kraakenstuff/PSU/PSU - Transformer.kicad_pcb

## KiCad design PSU - Transformer.kicad_pcb (2022-03-05)

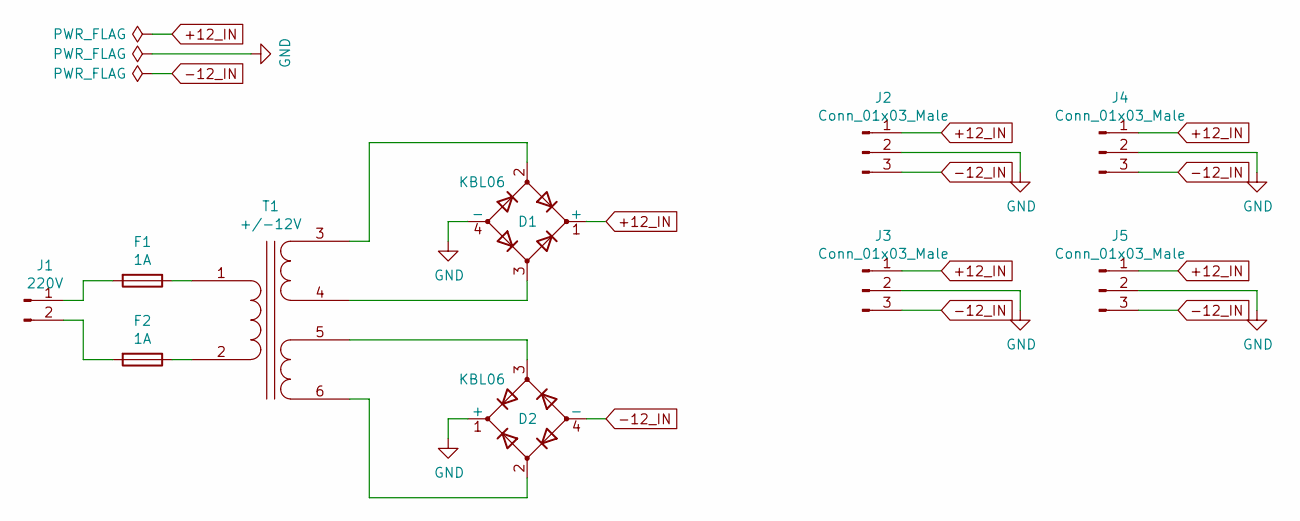
[picture p1: schematic PSU - Transformer.kicad_sch]

Parts:
D1, D2: KBL06; Diode_Bridge_18.5x5.5
F1, F2: 1A; Fuseholder5x20_horiz_SemiClosed_Casing10x25mm
J1: 220V; Terminal 2 contacts
J2, J3, J4, J5: Conn_01x03_Male; Klema x3
T1: +/-12V; Toroidal transformer 220V 150VA 2x12V

Connections:
+12_IN: D1.1 (+), J2.1, J3.1, J4.1, J5.1
-12_IN: D2.4 (-), J2.3, J3.3, J4.3, J5.3
GND: D1.4 (-), D2.1 (+), J2.2, J3.2, J4.2, J5.2
unnamed: D1.2, T1.3 (SA)
unnamed: D1.3, T1.4 (SB)
unnamed: D2.2, T1.6 (SD)
unnamed: D2.3, T1.5 (SC)
unnamed: F1.1, T1.1 (AA)
unnamed: F1.2, J1.1
unnamed: F2.1, T1.2 (AB)
unnamed: F2.2, J1.2

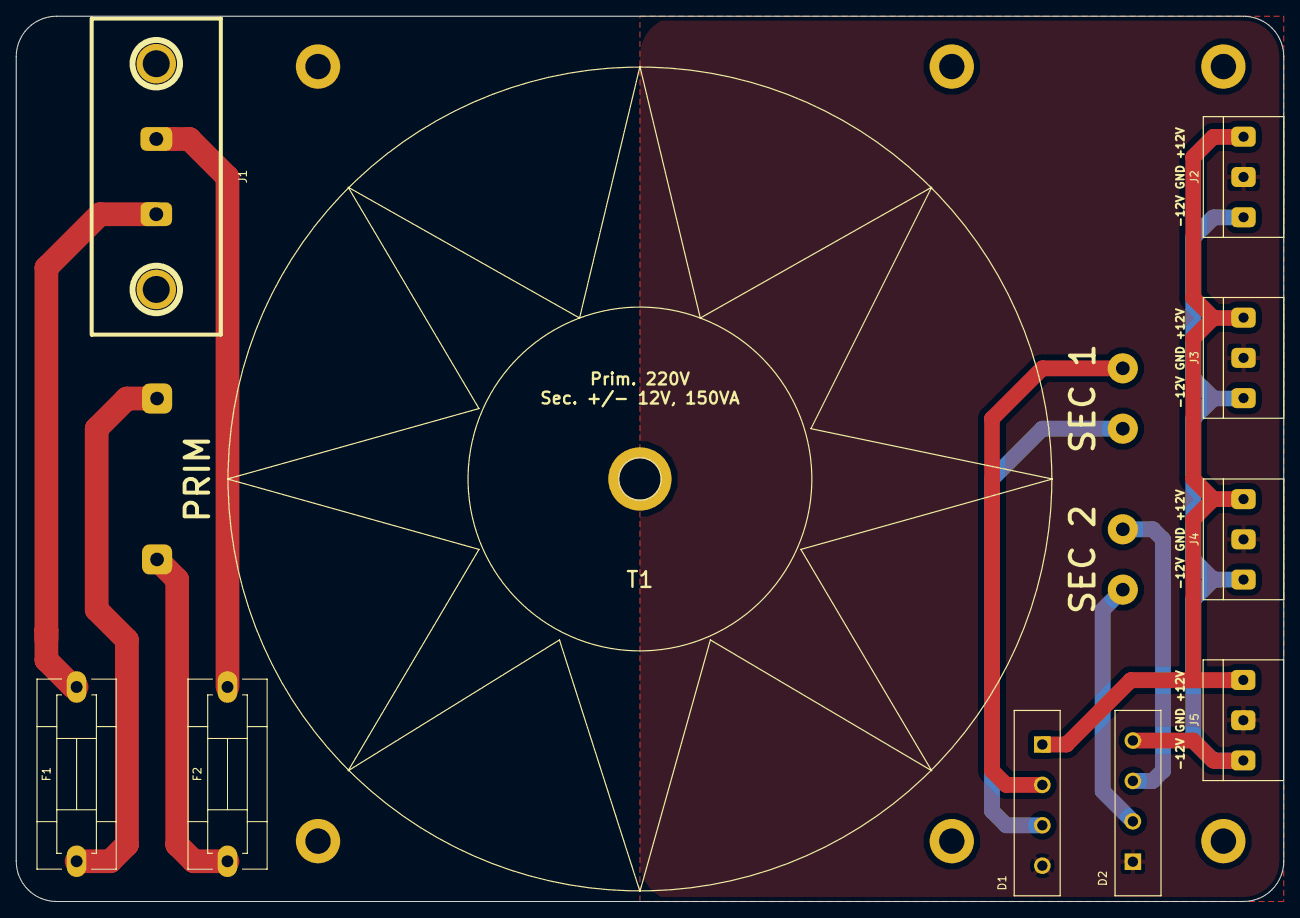
[picture p2: board PSU - Transformer.kicad_pcb from above]

Board: 2 copper layers, 160.0 x 111.8 mm, 10 parts (0 on the bottom side), 11 nets.
