kraakenstuff/PSU/PSU - Filter.kicad_pcb

## KiCad design PSU - Filter.kicad_pcb (2022-03-05)

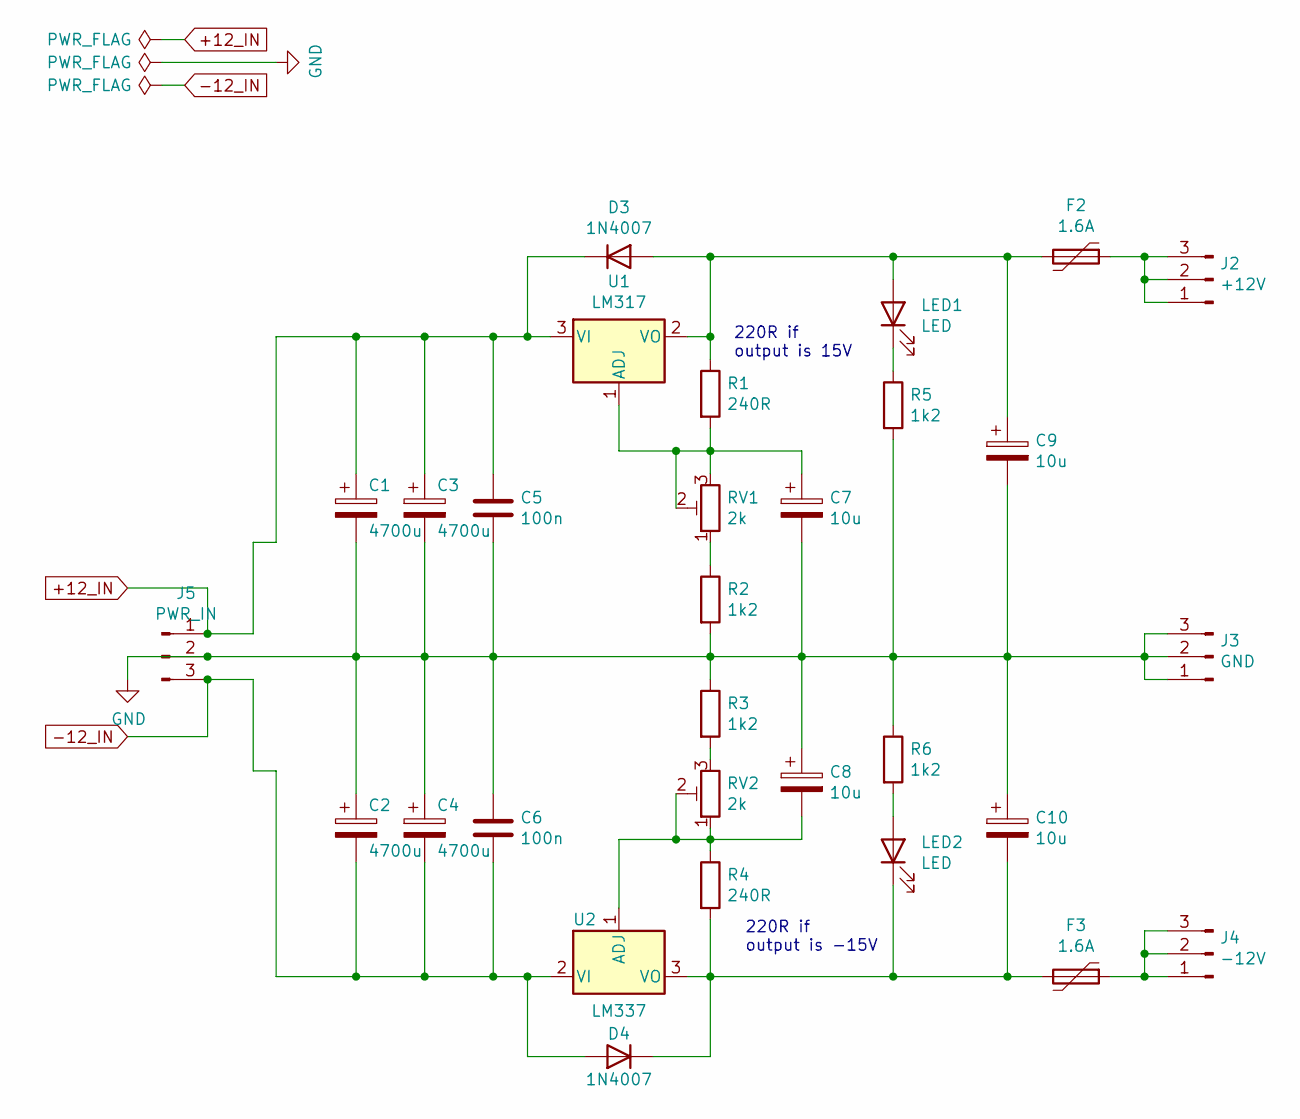
[picture p3: schematic PSU - Filter.kicad_sch]

Parts:
C1, C2, C3, C4: 4700u; CP_Radial_D17.0mm_P7.50mm
C5, C6: 100n; C_Rect_L10.0mm_W2.5mm_P7.50mm_MKS4
C7, C8, C9, C10: 10u; CP_Radial_D6.3mm_P2.50mm
D3, D4: 1N4007; D_DO-15_P12.70mm_Horizontal
F2, F3: 1.6A; C_Disc_D6.0mm_W2.5mm_P5.00mm
J2: +12V; Klema x3
J3: GND; Klema x3
J4: -12V; Klema x3
J5: PWR_IN; Klema x3
LED1, LED2: LED; LED_D5.0mm
R1, R4: 240R; R_Axial_DIN0414_L11.9mm_D4.5mm_P15.24mm_Horizontal
R2, R3: 1k2; R_Axial_DIN0414_L11.9mm_D4.5mm_P15.24mm_Horizontal
R5, R6: 1k2; R_Axial_DIN0207_L6.3mm_D2.5mm_P7.62mm_Horizontal
RV1, RV2: 2k; Potentiometer_Bourns_3296W_Vertical
U1: LM317; TO-220-3_Vertical
U2: LM337; TO-220-3

Connections:
+12_IN: C1.1, C3.1, C5.1, D3.1 (K), J5.1, U1.3 (VI); also elsewhere on the board
-12_IN: C2.2, C4.2, C6.2, D4.2 (A), J5.3, U2.2 (VI); also elsewhere on the board
GND: C1.2, C2.1, C3.2, C4.1, C5.2, C6.1, C7.2, C8.1, C9.2, C10.1, J3.1, J3.2, J3.3, J5.2, R2.2, R3.1, R5.2, R6.1; also elsewhere on the board
unnamed: C7.1, R1.2, RV1.2, RV1.3, U1.1 (ADJ)
unnamed: C8.2, R4.1, RV2.1, RV2.2, U2.1 (ADJ)
unnamed: C9.1, D3.2 (A), F2.2, LED1.2 (A), R1.1, U1.2 (VO)
unnamed: C10.2, D4.1 (K), F3.2, LED2.1 (K), R4.2, U2.3 (VO)
unnamed: F2.1, J2.1, J2.2, J2.3
unnamed: F3.1, J4.1, J4.2, J4.3
unnamed: LED1.1 (K), R5.1
unnamed: LED2.2 (A), R6.2
unnamed: R2.1, RV1.1
unnamed: R3.2, RV2.3

Notes on the sheet:
220R if output is -15V
220R if output is 15V

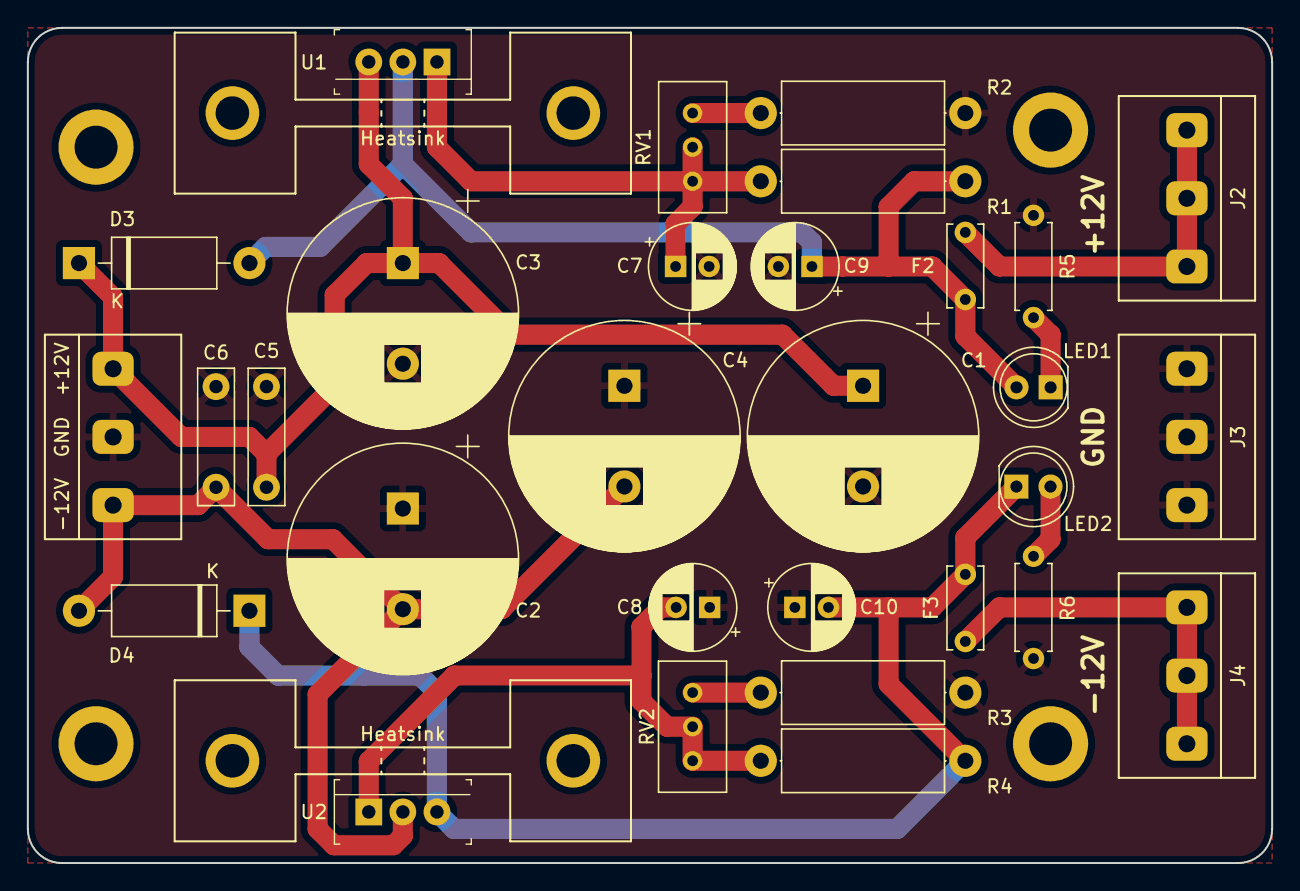
[picture p4: board PSU - Filter.kicad_pcb from above]

Board: 2 copper layers, 92.7 x 62.2 mm, 32 parts (0 on the bottom side), 13 nets.

Other parts of the board:
-12V  GND  +12V: PWR_IN; Klema x3
Heatsink: ALUMINIJUMSKI HLADNJAK TO-220/25; ALUMINIJUMSKI HLADNJAK TO-220_25
Heatsink#2: ALUMINIJUMSKI HLADNJAK TO-220/25; ALUMINIJUMSKI HLADNJAK TO-220_25

Their connections:
+12_IN: -12V GND +12V.1; also elsewhere on the board
-12_IN: -12V GND +12V.3; also elsewhere on the board
GND: -12V GND +12V.2; also elsewhere on the board
