kraakenstuff/PSU/(threads)

Thread 1 (2023-05-21):

BOM

Yulquen, 2023-05-21:
Hi. Thanks for sharing your design. Do you have a BOM for the boards? I could find most of the stuff, but can't recognize some components, like J1 on the transformer.
Thanks

Yulquen, 2023-05-21:
maybe something like that for J1
https://www.lcsc.com/product-detail/Barrier-Terminal-Blocks_Ningbo-Kangnex-Elec-WJ45C-A-2P_C8398.html
