kraakenstuff/PSU/(commit log)

2018-12-02 Release client. Fixed a short in +12 branch Changed 10uF footprint to 6.3/2.5mm New KiCad standard library Pointers to the KraakenStuffLib library
    [PSU - Filter [alternate].kicad_pcb, PSU - Filter.kicad_pcb, PSU - Filter.sch, PSU - Transformer.sch]
2018-12-02 Fixed library dependencies
    [PSU - Transformer.kicad_pcb, PSU - Transformer.sch]
2019-03-08 Finished. First round of testing passed
    [PSU - Filter-B.Cu.gbr, PSU - Filter-B.Mask.gbr, PSU - Filter-B.Paste.gbr, PSU - Filter-B.SilkS.gbr, PSU - Filter-Edge.Cuts.gbr, PSU - Filter-F.Cu.gbr, PSU - Filter-F.Mask.gbr, PSU - Filter-F.Paste.gbr]
2019-07-24 Made more space between caps and heatsinks on the filter board
    [PSU - Filter-B_Cu.gbr, PSU - Filter-B_Mask.gbr, PSU - Filter-B_Paste.gbr, PSU - Filter-B_SilkS.gbr, PSU - Filter-Edge_Cuts.gbr, PSU - Filter-F_Cu.gbr, PSU - Filter-F_Mask.gbr, PSU - Filter-F_Paste.gbr]
2019-07-24 Fixed gerber files
    [PSU - Filter-B.Cu.gbr, PSU - Filter-B.Mask.gbr, PSU - Filter-B.Paste.gbr, PSU - Filter-B.SilkS.gbr, PSU - Filter-B_Cu.gbr, PSU - Filter-B_Mask.gbr, PSU - Filter-B_Paste.gbr, PSU - Filter-B_SilkS.gbr]
2019-07-24 Added a label to the input of filter board
    [PSU - Filter-B.Cu.gbr, PSU - Filter-B.Mask.gbr, PSU - Filter-B.Paste.gbr, PSU - Filter-B.SilkS.gbr, PSU - Filter-Edge.Cuts.gbr, PSU - Filter-F.Cu.gbr, PSU - Filter-F.Mask.gbr, PSU - Filter-F.Paste.gbr]
2022-03-05 Adapted for KiCad6. Also fixed an error in silkscreen for the filter
    [PSU - Filter-B.Cu.gbr, PSU - Filter-B.Mask.gbr, PSU - Filter-B.SilkS.gbr, PSU - Filter-B_Cu.gbr, PSU - Filter-B_Mask.gbr, PSU - Filter-B_Paste.gbr, PSU - Filter-B_Silkscreen.gbr, PSU - Filter-Edge.Cuts.gbr]
